sagechoya/choyapad/case/3x3_+1_OLED_2026.9.26c_cover-plate_no-pin-hole-layout.png

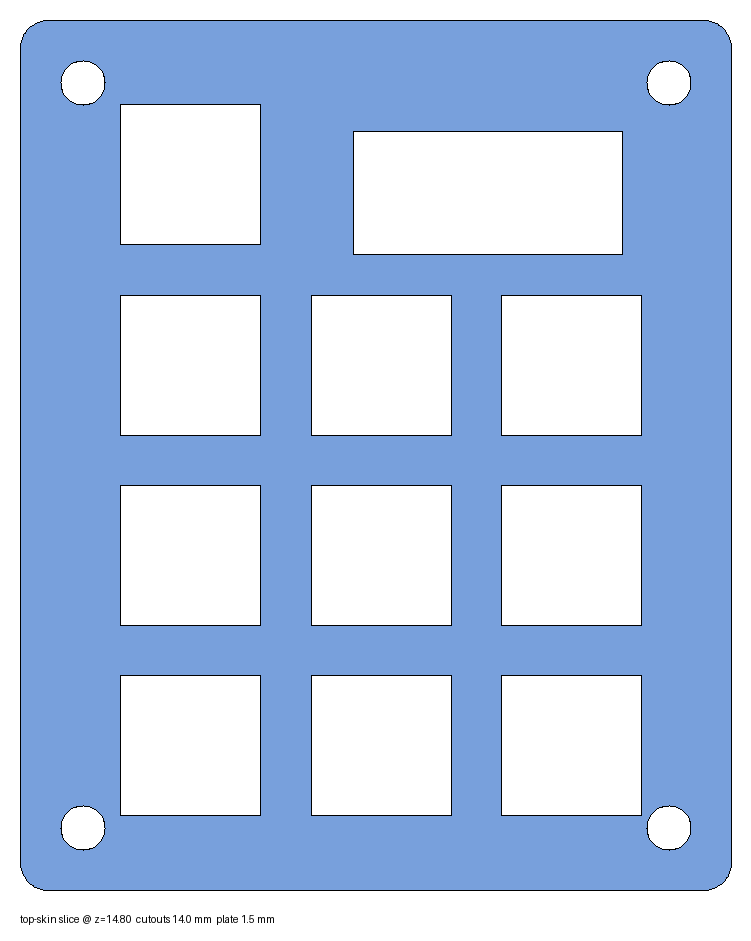
case/3x3_+1_OLED_2026.9.26c_cover-plate_no-pin-hole-layout.png
