sagechoya/choyapad/case/tray-choyapad-bottom.png

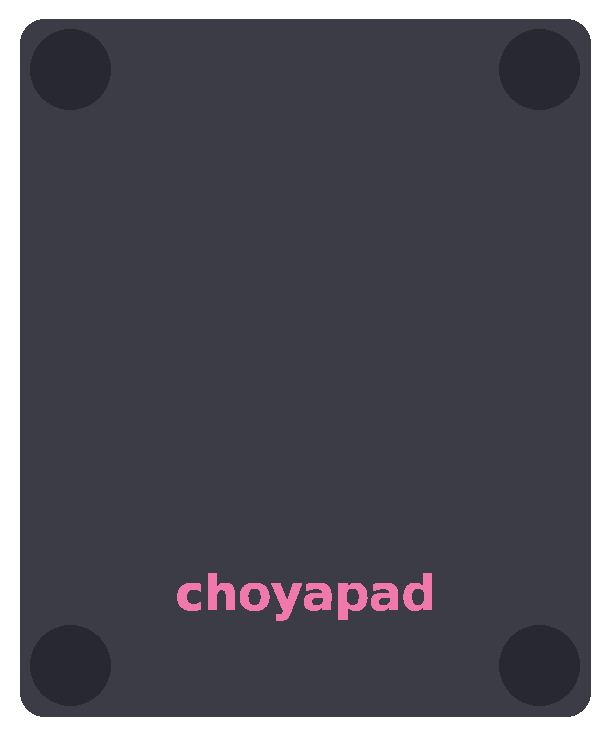
case/tray-choyapad-bottom.png
