sagechoya/choyapad/case/tray-tilt-3d.png

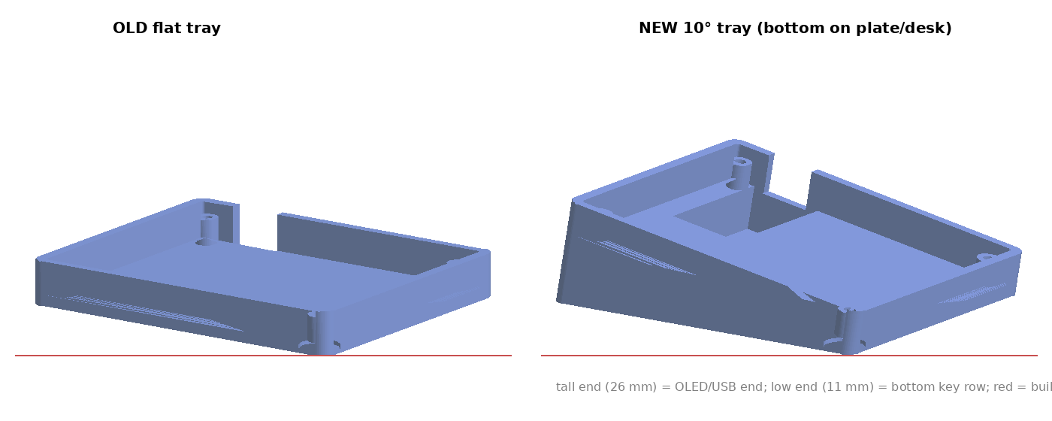
case/tray-tilt-3d.png
