sagechoya/choyapad/case/tray-tilt-compare.png

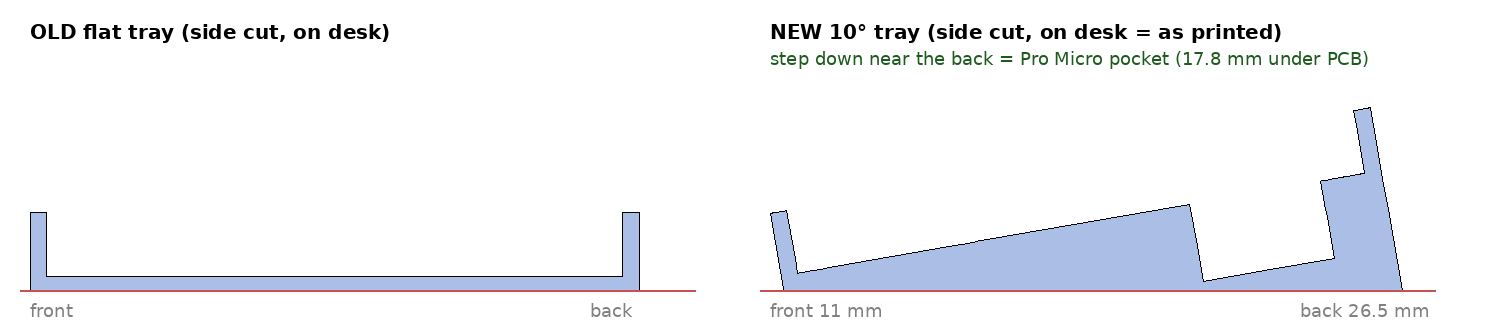
case/tray-tilt-compare.png
