sagechoya/choyapad/rotated-180/case/tray-rot180-heightmap.png

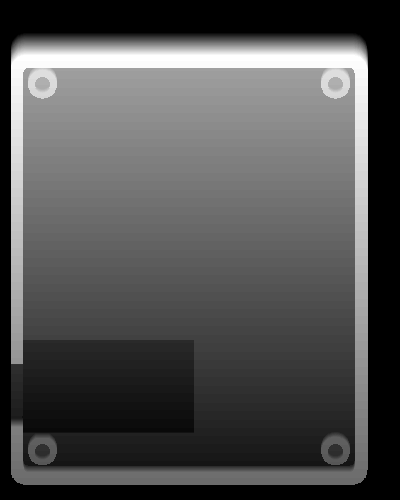
rotated-180/case/tray-rot180-heightmap.png
