sagechoya/choyapad/case/3x3_+1_OLED_2026.9.26c_tray-choya-2color_choya-inlay.stl

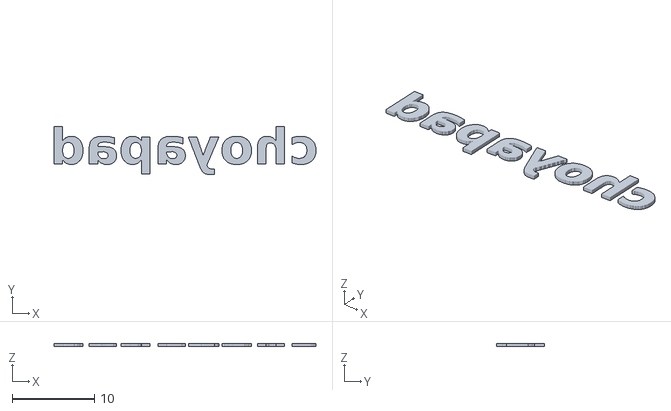
[picture p7: CAD file, 2026-10-22]
case/3x3_+1_OLED_2026.9.26c_tray-choya-2color_choya-inlay.stl
31.8 x 5.85 x 0.4
