sagechoya/choyapad/case/3x3_+1_OLED_2026.9.26c_tray-choya.stl

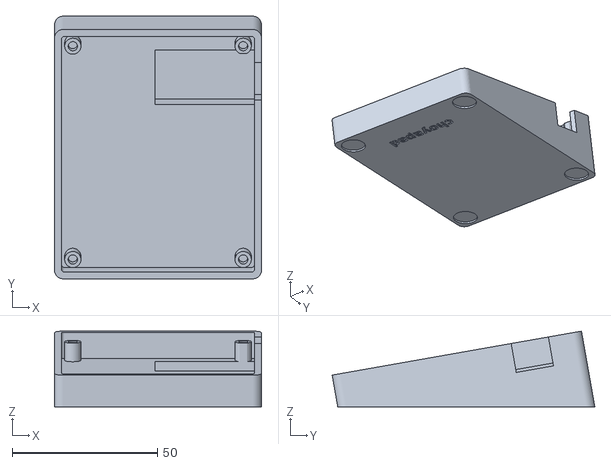
[picture p8: CAD file, 2026-10-22]
case/3x3_+1_OLED_2026.9.26c_tray-choya.stl
71.2 x 90.4 x 26.1
