sagechoya/choyapad/rotated-180/case/choyapad-rot180-tilt10_tray-choya-2color.3mf

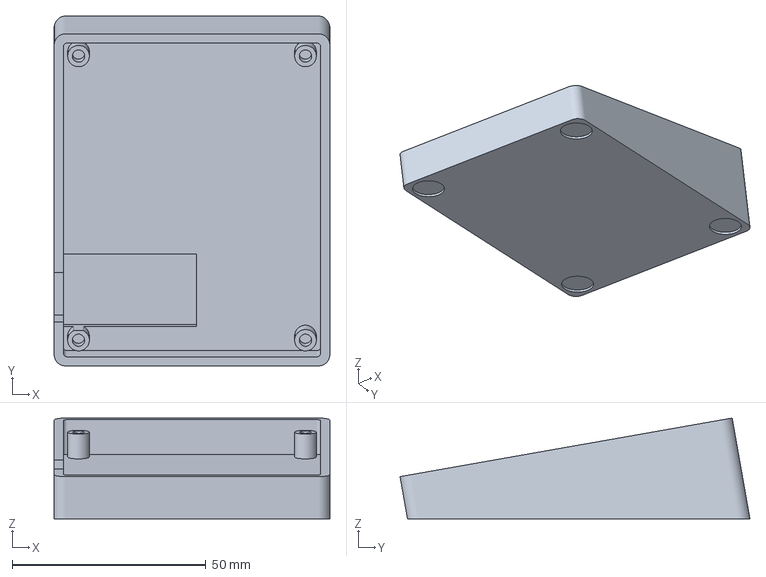
[picture p9: CAD file, 2026-10-30]
rotated-180/case/choyapad-rot180-tilt10_tray-choya-2color.3mf
71.2 x 90.4 x 26.1 mm
