sagechoya/choyapad/case/3x3_+1_OLED_2026.9.26c_cover-plate_no-pin-hole.3mf

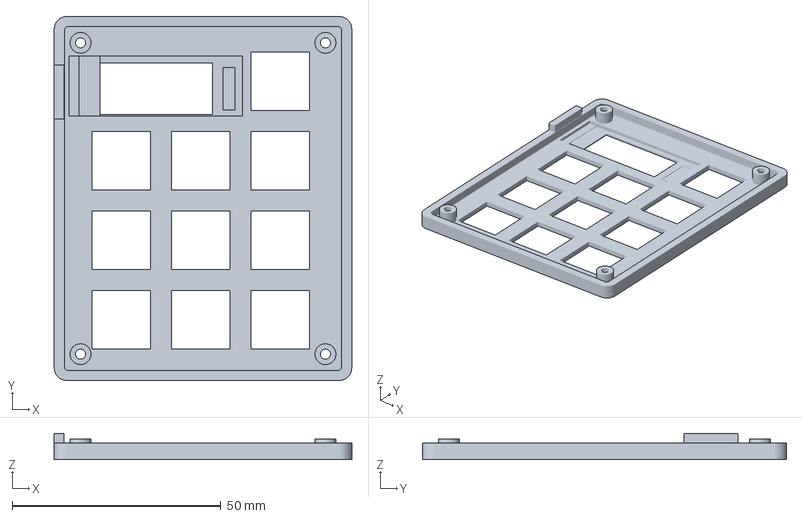
[picture p10: CAD file, 2026-10-22]
case/3x3_+1_OLED_2026.9.26c_cover-plate_no-pin-hole.3mf
71.2 x 87.1 x 6.30 mm
