sagechoya/choyapad/(list of files, cad)

Other CAD files:
rotated-180/case/choyapad-rot180-tilt10_tray-choya-2color_choya-inlay.stl
case/3x3_+1_OLED_2026.9.26c_tray-choya-2color_body.stl
rotated-180/case/choyapad-rot180-tilt10_tray-choya.stl
case/3x3_+1_OLED_2026.9.26c_tray-choya-2color.3mf
rotated-180/case/choyapad-rot180-tilt10_tray-choya-2color_body.stl
case/choyapad-tray-TILT10-2color.3mf
case/3x3_+1_OLED_2026.9.26c_cover-plate_no-pin-hole.stl
