sagechoya/choyapad/pcb/3x3_+1_OLED_2026.9.26c.kicad_pcb

## KiCad design pcb/3x3_+1_OLED_2026.9.26c.kicad_pcb (2026-10-22)

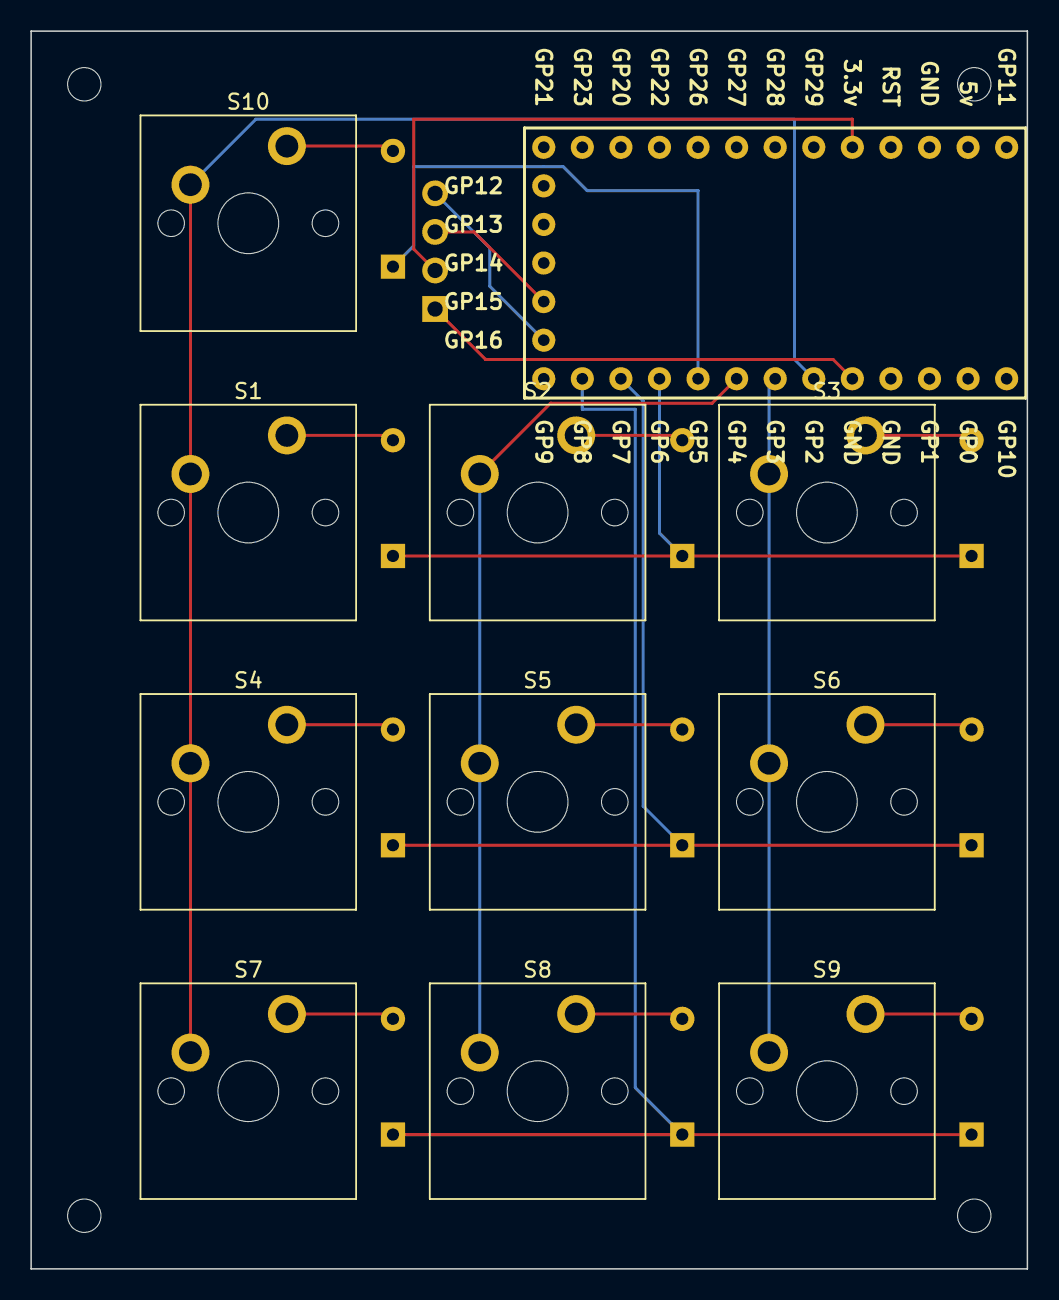
[picture p11: board 3x3_+1_OLED_2026.9.26c.kicad_pcb from above]

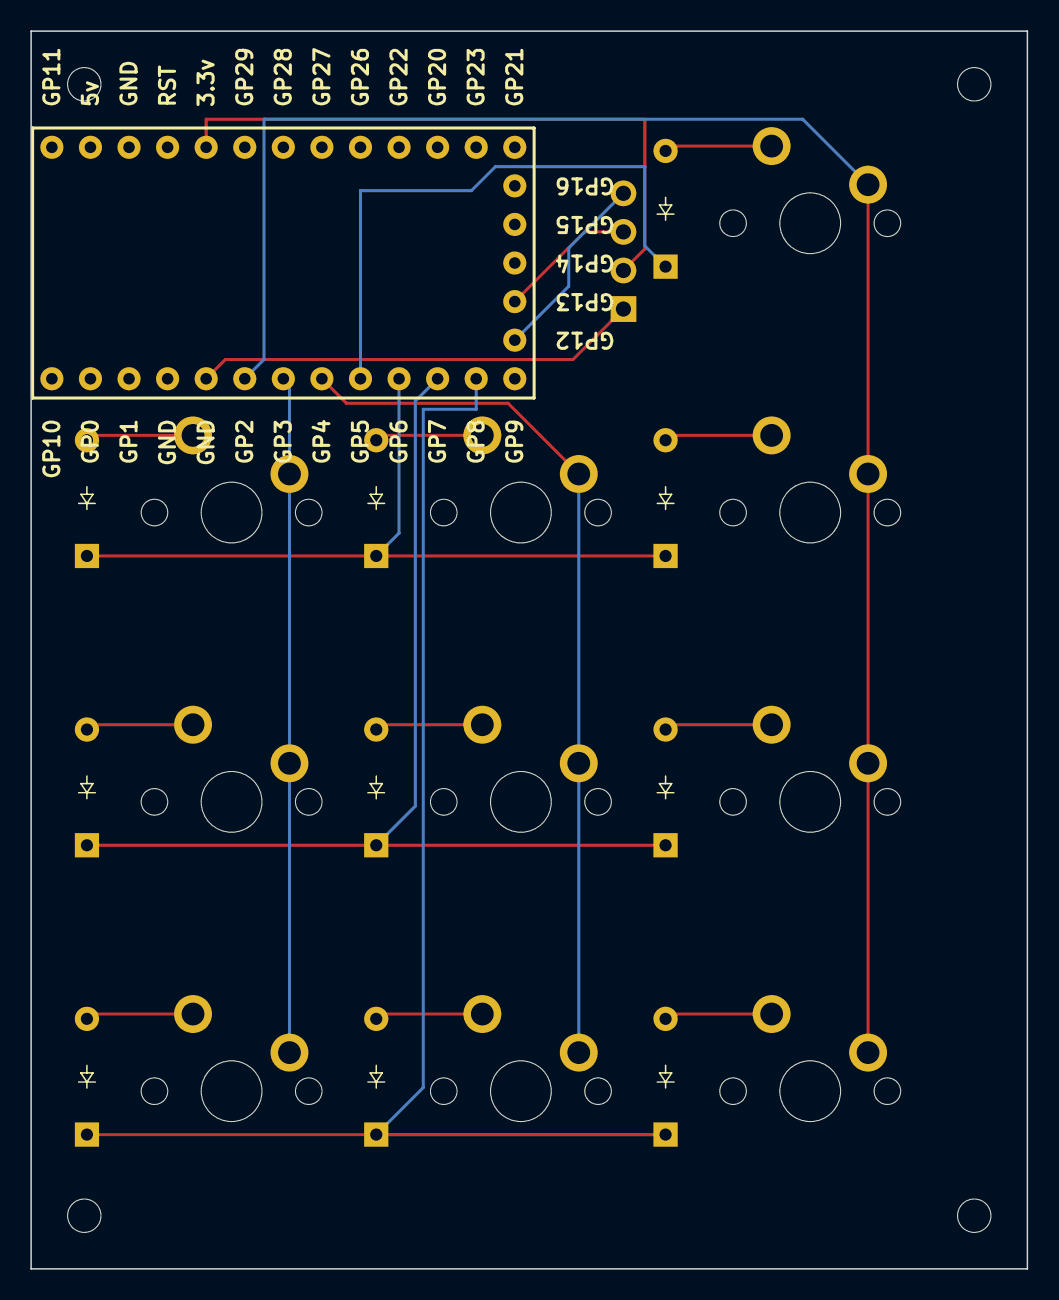
[picture p12: board 3x3_+1_OLED_2026.9.26c.kicad_pcb from below]

Board: 2 copper layers, 65.6 x 81.5 mm, 26 parts (11 on the bottom side), 21 nets.

Parts:
D1, D2, D3, D4, D5, D6, D7, D8, D9, D11: Diode_DO-35
H1, H2, H3, H4: MountingHole_M2; MountingHole_2.2mm_M2
J1: OLED_128x32
S1, S2, S3, S4, S5, S6, S7, S8, S9, S10: MX_PCB_1.00u
U1: RP2040_Pro_Micro

Connections:
Column 0: S1.1, S4.1, S7.1, S10.1, U1.6 (GP2)
Column 1: S2.1, S5.1, S8.1, U1.8 (GP4)
Column 2: S3.1, S6.1, S9.1, U1.7 (GP3)
unnamed: D1.2 (A), S1.2
unnamed: D2.2 (A), S2.2
unnamed: D3.2 (A), S3.2
unnamed: D4.2 (A), S4.2
unnamed: D5.2 (A), S5.2
unnamed: D6.2 (A), S6.2
unnamed: D7.2 (A), S7.2
unnamed: D8.2 (A), S8.2
unnamed: D9.2 (A), S9.2
unnamed: D11.2 (A), S10.2
OLED_3.3V: J1.2 (VCC), U1.27 (3.3v)
OLED_GND: J1.1 (GND), U1.5 (GND)
OLED_SCL: J1.3 (SCL), U1.15 (GP13)
OLED_SDA: J1.4 (SDA), U1.14 (GP12)
Row 0: D11.1 (K), U1.9 (GP5)
Row 1: D1.1 (K), D2.1 (K), D3.1 (K), U1.10 (GP6)
Row 2: D4.1 (K), D5.1 (K), D6.1 (K), U1.11 (GP7)
Row 3: D7.1 (K), D8.1 (K), D9.1 (K), U1.12 (GP8)
