sagechoya/choyapad/(commit log)

2026-10-22 choyapad: 3x3+1 OLED macropad (PCB rev 2026.9.26c), case and QMK firmware
    [3x3_+1_OLED_2026.9.26c-B_Cu.gbl, 3x3_+1_OLED_2026.9.26c-B_Mask.gbs, 3x3_+1_OLED_2026.9.26c-B_Paste.gbp, 3x3_+1_OLED_2026.9.26c-B_Silkscreen.gbo, 3x3_+1_OLED_2026.9.26c-Edge_Cuts.gm1, 3x3_+1_OLED_2026.9.26c-F_Cu.gtl, 3x3_+1_OLED_2026.9.26c-F_Mask.gts, 3x3_+1_OLED_2026.9.26c-F_Paste.gtp]
2026-10-30 Add rotated-180 variant: OLED-at-front tray and matching QMK firmware (choyapad_rot180)
    [choyapad-rot180-tilt10_tray-choya-2color.3mf, choyapad-rot180-tilt10_tray-choya-2color_body.stl, choyapad-rot180-tilt10_tray-choya-2color_choya-inlay.stl, choyapad-rot180-tilt10_tray-choya.stl]
